mlisak/E-Ink_Dashbord/PCB/eink_dashboard.kicad_pcb

## KiCad design PCB/eink_dashboard.kicad_pcb (2019-04-25)

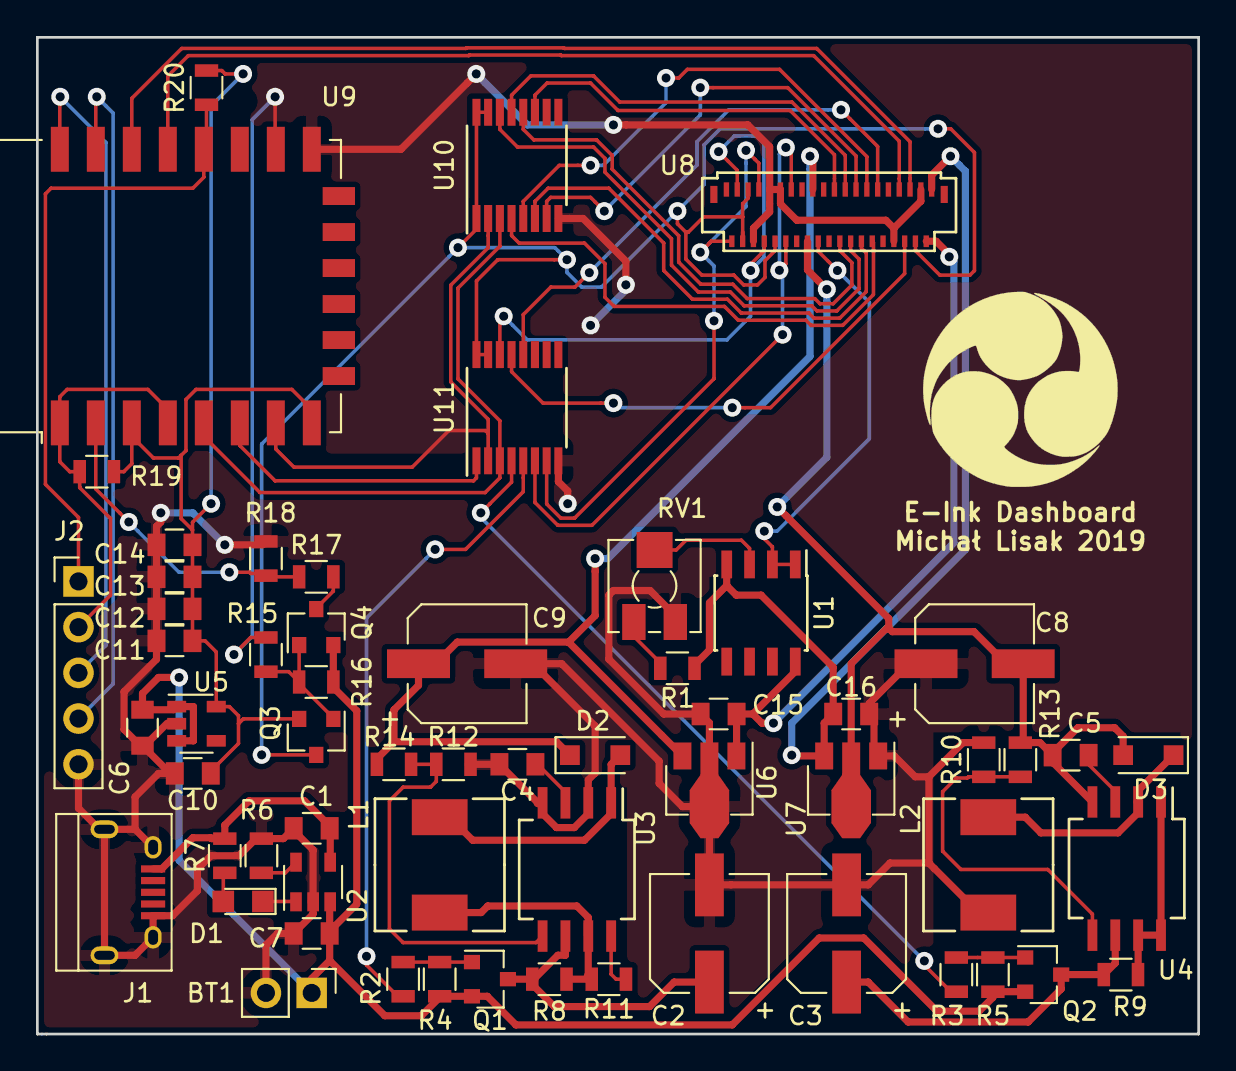
[picture p1: board eink_dashboard.kicad_pcb from above]

Board: 2 copper layers, 64.5 x 55.4 mm, 60 parts (0 on the bottom side), 56 nets.

Parts:
BT1: Battery_Cell; Pin_Header_Straight_1x02_Pitch2.54mm
C1, C7: 4.7u; C_0805
C2, C3, C8, C9: 47u; CP_Elec_6.3x5.3
C4, C5: 680p; C_0805
C6, C10: 1u; C_0805
C11, C12, C13, C14, C15, C16: 100n; C_0805
D1: LED; LED_0805
D2, D3: SS24; D_SOD-123F
J1: USB_B_Micro; USB_Micro-B
J2: Conn_01x05; Pin_Header_Straight_1x05_Pitch2.54mm
L1, L2: 68 uH; Inductor_Wurth_HCM-7050
Q1, Q2, Q3, Q4: IRLML6402; SOT-23
R1, R4, R5: 47k; R_0805
R2, R3, R15: 10; R_0805
R6: 2k; R_0805
R7: 470; R_0805
R8, R9: 0.39; R_0805
R10: 15k; R_0805
R11: 180; R_0805
R12: 1.2k; R_0805
R13: 1k; R_0805
R14: 20k; R_0805
R16: 47K; R_0805
R17: 33k; R_0805
R18, R19, R20: 10k; R_0805
RV1: 10k; Potentiometer_Trimmer_Vishay_TS53YJ
U1: LM358; SOIC-8_3.9x4.9mm_Pitch1.27mm
U2: MCP73831; SOT-23-5
U3, U4: MC34063; SO-8_5.3x6.2mm_Pitch1.27mm
U5: MIC5504-3.3YM5; SOT-23-5
U6: L78L15; SOT-89-3
U7: L79L15; SOT-89-3
U8: ED060SC4
U9: ESP-12F; ESP-12E
U10, U11: CD4094; TSSOP-16_4.4x5mm_Pitch0.65mm

Connections:
+3V3: C10.1, C11.1, C12.1, C13.1, C14.1, Q3.2, R19.2, R20.2, U5.5, U9.3, U9.8
+15V: C15.1, U1.8, U6.1, U8.2
+22V: C9.1, D2.1, R14.2, U6.3, U8.23
+BATT: BT1.1, C6.1, C7.1, Q1.2, Q2.2, Q4.2, R4.2, R5.2, R16.2, U2.3, U5.1, U5.3
-15V: C16.1, R1.1, U1.4, U7.3, U8.1
-20V: C5.2, C8.2, D3.2, R13.1, U4.4, U7.2, U8.24
CKV: U8.33, U8.38, U11.7
CL: U8.5, U9.20
CLK: U9.5, U10.3, U11.3
D: U9.7, U10.2, U11.2
EINK_EN: R15.2, U9.16
EINK_VDD: Q3.3, U8.4, U8.30, U8.35, U8.36, U10.1, U10.15, U10.16, U11.15, U11.16
GMODE: U8.27, U8.28, U11.6
GND: BT1.2, C1.2, C2.2, C3.2, C4.2, C6.2, C7.2, C8.1, C9.2, C10.2, C11.2, C12.2, C13.2, C14.2, C15.2, C16.2, J1.5, J1.6, J2.5, L2.2, R6.2, R10.2, R12.1, R18.1, RV1.1, U2.2, U3.2, U3.4, U5.2, U6.2, U7.1, U8.3, U8.8, U8.29, U8.31, U8.34, U9.15, U10.8, U11.8
LE: U8.6, U11.13
NEG_EN: R3.2, U11.4
unnamed: C1.1, J1.1, R7.2, U2.4
unnamed: C2.1, Q1.3, R8.1, U3.6
unnamed: C3.1, Q2.3, R9.1, U4.6
unnamed: C4.1, U3.3
unnamed: C5.1, U4.3
unnamed: D1.1, U2.1
unnamed: D1.2, R7.1
unnamed: D2.2, L1.2, U3.1
unnamed: D3.1, L2.1, U4.2
unnamed: J2.1, R20.1, U9.18
unnamed: J2.3, U9.22
unnamed: J2.4, U9.21
unnamed: L1.1, R8.2, R11.2, U3.7
unnamed: Q1.1, R2.1, R4.1
unnamed: Q2.1, R3.1, R5.1
unnamed: Q3.1, Q4.1, R15.1, R16.1
unnamed: Q4.3, R17.2
unnamed: R1.2, RV1.3
unnamed: R6.1, U2.5
unnamed: R9.2, U4.1, U4.7, U4.8
unnamed: R10.1, R13.2, U4.5
unnamed: R11.1, U3.8
unnamed: R12.2, R14.1, U3.5
unnamed: R17.1, R18.2, U9.2
unnamed: RV1.2, U1.3
unnamed: U8.12, U10.4
unnamed: U8.13, U10.5
unnamed: U8.14, U10.6
unnamed: U8.15, U10.7
unnamed: U8.19, U10.11
unnamed: U8.18, U10.12
unnamed: U8.17, U10.13
unnamed: U8.16, U10.14
OE: U8.7, U9.19
POS_EN: R2.2, U11.5
SPH: U8.11, U11.12
SPV: U8.32, U8.37, U11.14
STR: U9.6, U11.1
VCOM: U1.1, U1.2, U8.22
~RST: J2.2, R19.1, U9.1, U9.4
