mlisak/E-Ink_Dashbord/(commit log)

2019-04-25 PCB design project created
    [eink_dashboard.kicad_pcb, eink_dashboard.sch]
2019-04-25 +22V and -20V generation circuitry added
    [eink_dashboard.sch]
2019-04-25 Added +/-15V linear regulators
    [eink_dashboard.sch]
2019-04-25 Added opamp to generate adjustabe VCOM
    [eink_dashboard.sch]
2019-04-25 3.3V LDO regulator added
    [eink_dashboard.sch]
2019-04-25 Battery charging circuitry added
    [eink_dashboard.sch]
2019-04-25 Added footprint library for ED060SC4 E-ink display
2019-04-25 Control circuitry added
    [eink_dashboard.sch]
2019-04-25 Placed resistors values inside symbols
    [eink_dashboard.sch]
2019-04-25 Placed actual battery symbol instead of connector
    [eink_dashboard.sch]
2019-04-25 Pulled ADC and EINK_VDD mosfets to +BATT instead of +3.3V
    [eink_dashboard.sch]
2019-04-25 Swapped LD3985 LDO regulator to MIC5504
    [eink_dashboard.sch]
2019-04-25 Footprints assigned to elements
    Components values tweaked to match available products
    [eink_dashboard.sch]
2019-04-25 Fixed schematic to use correct SPI pins on ESP-12F
    [eink_dashboard.sch]
2019-04-25 Schematic annotated, netlist generated
    *.net files added to .gitignore
    [eink_dashboard.sch]
2019-04-25 Separated R15/R16 name fields
    [eink_dashboard.sch]
2019-04-25 Routed separate sections of PCB
    [eink_dashboard.kicad_pcb]
2019-04-25 STR and D pins swapped for better routing
    [eink_dashboard.sch]
2019-04-25 PCB mostly routed
    Final board layout defined
    [eink_dashboard.kicad_pcb]
2019-04-25 Finished routing board
    [eink_dashboard.kicad_pcb]
2019-04-25 Shift registers moved farther apart
    [eink_dashboard.kicad_pcb]
2019-04-25 Tight clearances cleaned up
    [eink_dashboard.kicad_pcb]
2019-04-25 Ground pours tweaked
    Added pour keepout areas (F.Cu) under ICs, inductors and FPC connector
    Pour minimal width increased
    [eink_dashboard.kicad_pcb]
2019-04-25 Silkscreen labels placed in better positions
    [eink_dashboard.kicad_pcb]
2019-04-25 Mitsudomoe symbol and board title added on silkscreen
    [eink_dashboard.kicad_pcb]
2019-04-25 R6 changed to 2k
    [eink_dashboard.kicad_pcb, eink_dashboard.sch]
2019-04-25 BOM catalog added to .gitignore
2019-04-25 IMPORTANT FIX: D3 direction switched
    [eink_dashboard.kicad_pcb, eink_dashboard.sch]
2019-04-25 IMPORTANT FIX: D and STR swapped on ESP module
    [eink_dashboard.kicad_pcb, eink_dashboard.sch]
2019-04-25 SPI initialization added
2019-04-25 Changed EINK_EN to GPIO15 (was GPIO2)
    This is to not interfere with LED present on ESP12 modules
    [eink_dashboard.kicad_pcb, eink_dashboard.sch]
2019-04-25 Removed SPI event callback
2019-04-25 IO initialization tweaked
    SPI clock changed to 2 MHz
    EINK_EN set high aftter init
2019-04-25 SPI transmit implemented
    Writing data (D0~D7) to E-Ink module implemented
